Kushagra340/KushagraBot-ROS2/media/tf_tree.pdf

view_frames Result

Recorded at time: 1783702412.0483854

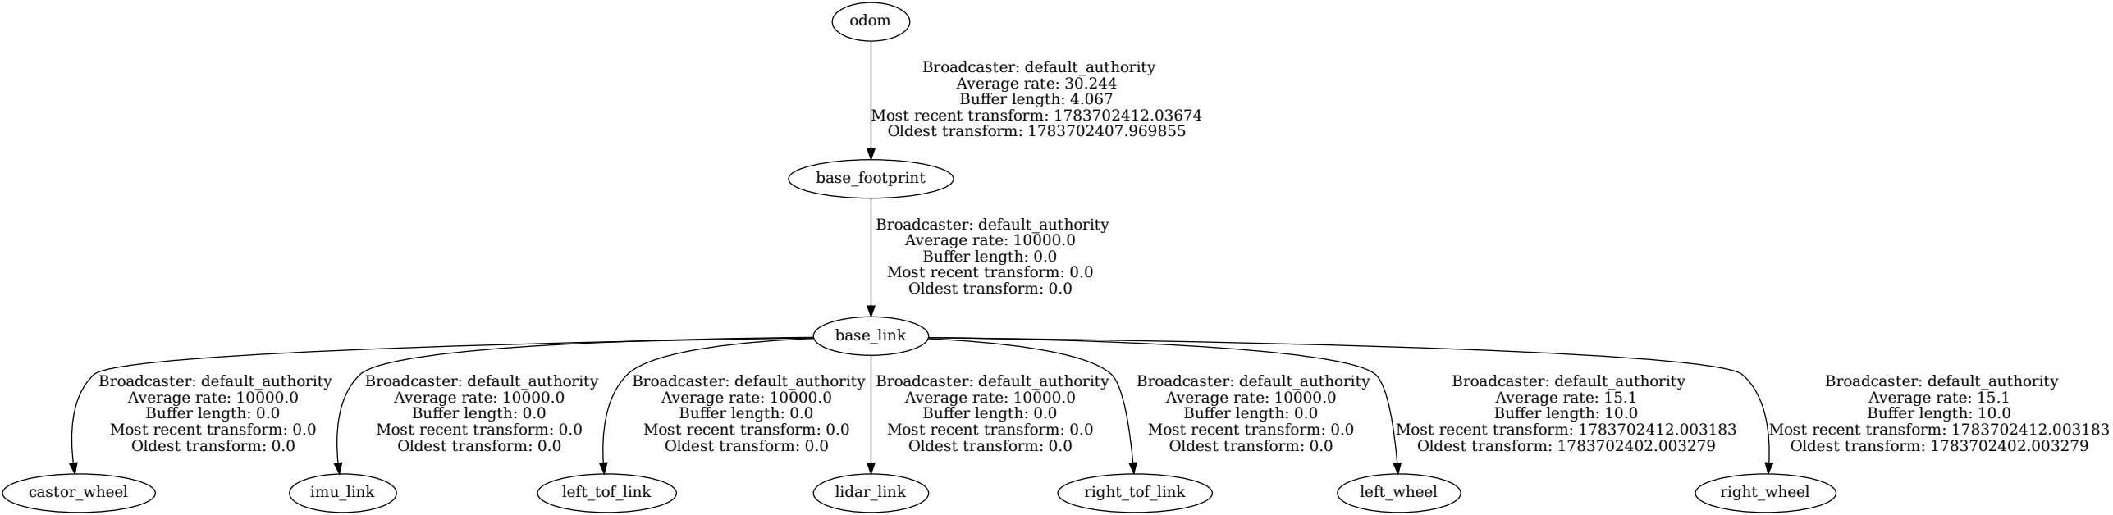
[picture p1: figure]
base_footprint; base_link; Broadcaster: default_authority Average rate: 10000.0 Buffer length: 0.0 Most recent transform: 0.0 Oldest transform: 0.0; castor_wheel; imu_link; left_tof_link; lidar_link; right_tof_link; left_wheel; Broadcaster: default_authority Average rate: 15.1 Buffer length: 10.0 Most recent transform: 1783702412.003183 Oldest transform: 1783702402.003279; right_wheel; odom; Broadcaster: default_authority Average rate: 30.244 Buffer length: 4.067 Most recent transform: 1783702412.03674 Oldest transform: 1783702407.969855
