Kushagra340/KushagraBot-ROS2/hardware/bom/Robotics_Project_BOM_Final.xlsx

Sr. No. | Website | Component Name | Link | Quantity | Est. Unit Price (₹) | Total Price (₹)
1 | robu.in | KCD1 2 Pin 10A 250V AC SPST Red Rocker Switch | https://robu.in/product/kcd1-101-spst-mini-rocker-switch-2pinon-off/ | 5 | ₹11.00 | ₹55.00 | 3112.00
2 | robu.in | Noel Soldering Iron Kit 25W 7 in 1 | https://robu.in/product/noel-soldering-iron-kit-25w-7-in-1/ | 1 | ₹490.00 | ₹490.00
3 | robu.in | High Quality Ultra Flexible 24AWG Silicone Wire Red (per m) | https://robu.in/product/high-quality-ultra-flexible-24awg-silicone-wire-red/ | 5 | ₹9.00 | ₹45.00
4 | robu.in | Aluminum Electrolytic Capacitor 100uF | https://robu.in/product/elxz350ell101mf15d-chemi-con-aluminum-electrolytic-capacitor-100uf-3/ | 5 | ₹17.00 | ₹85.00
5 | robu.in | 24AWG High Voltage Silicone Wire 3000V Black (per m) | https://robu.in/product/24awg-high-voltage-silicone-wire-3000v-black/ | 5 | ₹12.00 | ₹60.00
6 | robu.in | VL53L0X ToF Based Lidar Laser Distance Sensor | https://robu.in/product/vl53l0x-tof-based-lidar-laser-distance-sensor/ | 3 | ₹121.00 | ₹363.00
7 | robu.in | N20 3V 150RPM Micro Metal Gear Motor With Encoder | https://robu.in/product/n20-3v-150rpm-micro-metal-gear-motor-with-encoder/ | 2 | ₹526.00 | ₹1052.00
8 | robu.in | MPU-6050 Gyro Sensor & Accelerometer | https://robu.in/product/mpu-6050-gyro-sensor-2-accelerometer/ | 1 | ₹169.00 | ₹169.00
9 | robu.in | 34mm Mini Car N20 Motor Wheel Rubber Small Wheel | https://robu.in/product/34mm-mini-car-n20-motor-wheel-rubber-small-wheel/ | 4 | ₹50.00 | ₹200.00
10 | robu.in | Digital Multimeter Small Yellow Color LCD | https://robu.in/product/digital-multimeter-small-yellow-color-lcd-ac-dc-measuring-voltage-current/ | 1 | ₹171.00 | ₹171.00
11 | robu.in | 1203B PWM 6V 12V 24V 28V 3A DC Motor Speed Regulator | https://robu.in/product/1203b-pwm-6v-12v-24v-28v-3a-dc-motor-speed-regulator/ | 1 | ₹84.00 | ₹84.00
12 | robu.in | Green ESP32 Breakout Board for 38Pin ESP32 | https://robu.in/product/green-esp32-breakout-board-for-38pin-esp32-development-board/ | 1 | ₹235.00 | ₹235.00
13 | robu.in | 12V Cold White 5050 SMD LED Strip 1Meter | https://robu.in/product/12v-cold-white-5050-smd-led-strip-1meter/ | 1 | ₹103.00 | ₹103.00
14 | robokits.co.in | M3 x 20 mm CSK Bolt Stainless Steel 304 (Piece) | https://robokits.co.in/mechanical-parts/nut-bolts-standoffs/flat-head-csk-bolt/m3-x-20-mm-csk-bolt-stainless-steel-304-moq-25-pcs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 | 50 | ₹2.36 | ₹118.00 | 693.84
15 | robokits.co.in | DC-DC Boost 25V 2A MT3608 | https://robokits.co.in/power-supply/dc-dc-power-supply/dc-dc-boost-25v-2a-mt3608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 | 2 | ₹33.04 | ₹66.08
16 | robokits.co.in | M3 Nuts 304 Stainless Steel (Piece) | https://robokits.co.in/robot-parts/nut-bolts-standoffs/nuts/m3-nuts-304-stainless-steel-moq-50-pcs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 | 50 | ₹1.18 | ₹59.00
17 | robokits.co.in | M3 x 3 mm Brass Heat Threaded Round Insert Nut (Piece) | https://robokits.co.in/robot-parts/nut-bolts-standoffs/nuts/m3-x-3-mm-brass-heat-threaded-round-insert-nut-moq-25-pcs.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 | 25 | ₹4.48 | ₹112.10
18 | robokits.co.in | M3 Flat Washer 304 Stainless Steel (Piece) | https://robokits.co.in/robot-parts/nut-bolts-standoffs/washers/m3-flat-washer-304-stainless-steel-moq-50-pcs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 | 50 | ₹2.83 | ₹141.60
19 | robokits.co.in | Two Way Motor Drive Module DRV8833 | https://robokits.co.in/motor-drives-drivers/dc-motor-driver/two-way-motor-drive-module-drv8833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 | 1 | ₹94.40 | ₹94.40
20 | robokits.co.in | Turbo Fan Blower | https://robokits.co.in/3d-printer/accessories/turbo-fan-blower | 1 | ₹102.66 | ₹102.66
21 | flyrobo.in | 18650 Battery Shield for Raspberry Pi and Arduino ESP8266 | https://www.flyrobo.in/18650-battery-shield-for-raspberry-pi-andarduino-esp8266 | 1 | ₹157.00 | ₹157.00 | 1192.00
22 | flyrobo.in | Li-ion 18650 3.7V 2200mAh Battery 1C | https://www.flyrobo.in/li-ion-18650-3.7v-2200mah-battery-1c | 2 | ₹96.00 | ₹192.00
23 | flyrobo.in | Mini 3pi Car N20 Caster Robot Ball Wheel | https://www.flyrobo.in/mini-3pi-car-n20-caster-robot-ball-wheel | 1 | ₹39.00 | ₹39.00
24 | flyrobo.in | 230pcs XH 2.54 Terminal Kit Housing Pin Header JST Connector | https://www.flyrobo.in/230pcs-xh-2.54-2p-3p-4p-5pin-2.54mm-pitch-terminal-kit-housing-pin-header-jst-connector | 1 | ₹366.00 | ₹366.00
25 | flyrobo.in | ESP32 NodeMCU WiFi Bluetooth Development Module 30 Pin | https://www.flyrobo.in/esp32-node-mcu-wifi-bluetooth-development-module-30-pin | 1 | ₹438.00 | ₹438.00
 |  |  |  |  | GRAND TOTAL: | ₹4997.84
