Kushagra340/KushagraBot-ROS2/hardware/cad/chassis v2.SLDPRT

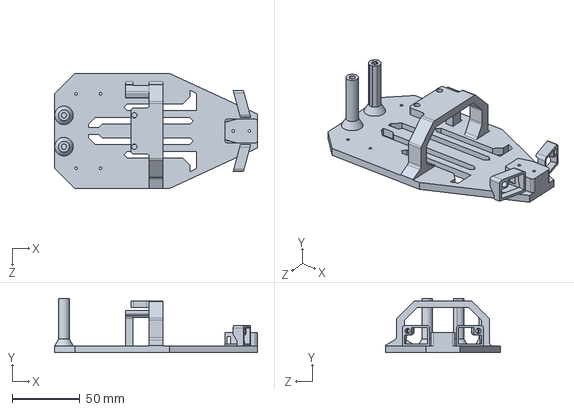
[picture p2: CAD file, 2026-10-18]
hardware/cad/chassis v2.SLDPRT
150.0 x 40.0 x 85.0 mm
