Kushagra340/KushagraBot-ROS2/hardware/cad/BASE PLATE V3.SLDPRT

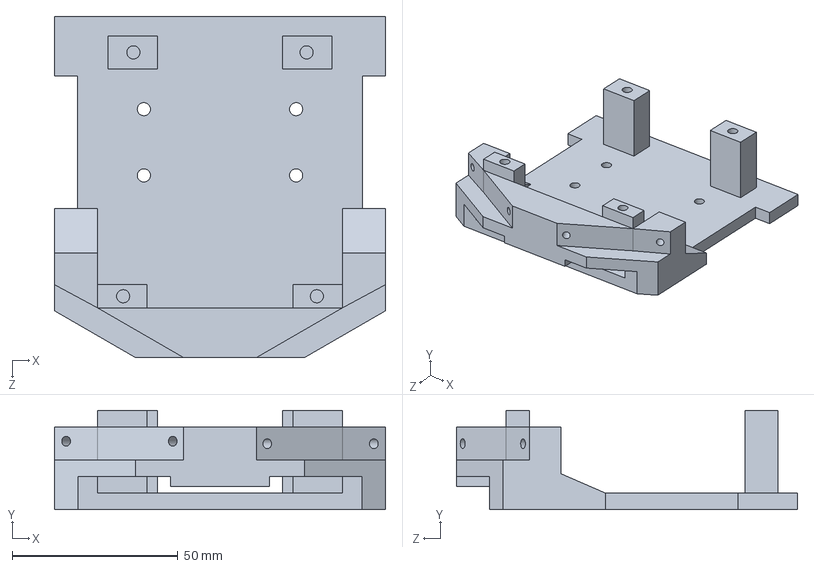
[picture p3: CAD file, 2026-10-18]
hardware/cad/BASE PLATE V3.SLDPRT
100.0 x 30.0 x 103.0 mm
