Kushagra340/KushagraBot-ROS2/hardware/cad/Bracket.SLDPRT

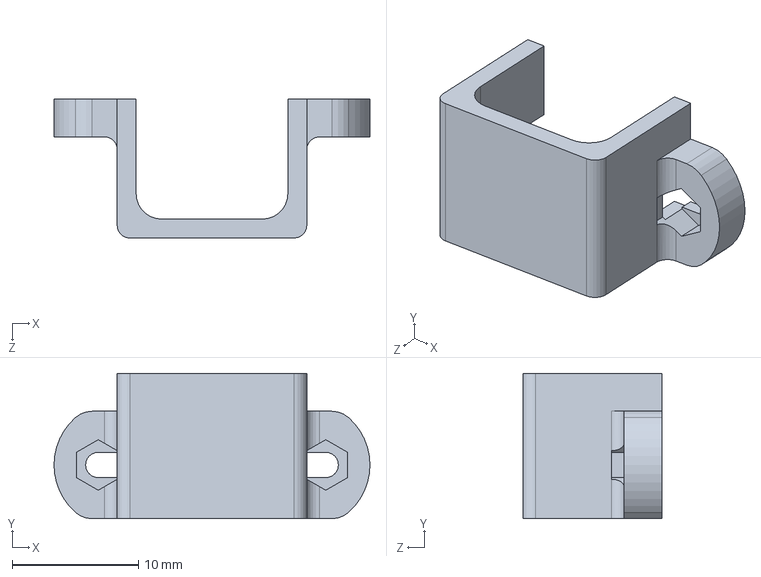
[picture p4: CAD file, 2026-10-18]
hardware/cad/Bracket.SLDPRT
25.0 x 11.5 x 11.0 mm
