Kushagra340/KushagraBot-ROS2/(list of files, cad)

Other CAD files:
hardware/cad/chassis v2.STL
