Kushagra340/KushagraBot-ROS2/docs/robot_building_mastery_guide.md

# The Path to Mastery: Building a "Good" Robot in ROS 2

Building a "good" robot means creating a system that is robust, reliable, and predictable. A robot that looks cool but fails when a single sensor disconnects is a toy; a robot that handles edge cases gracefully and moves smoothly is a professional machine. 

This document serves as a comprehensive roadmap from beginner to mastery, covering both simulation and real-world hardware using ROS 2.

---

## 1. Nav2 Controllers (Local Planners) Comparison

The "Controller" (or Local Planner) is the brain behind the robot's physical movement. It takes the global path and generates velocity commands (`cmd_vel`) to avoid dynamic obstacles and reach the goal smoothly.

Choosing the right controller drastically changes how "good" your robot feels.

| Controller | Full Name | Best For | Pros | Cons |
| :--- | :--- | :--- | :--- | :--- |
| **DWB** | Dynamic Window Approach | General purpose diff-drive | Reliable, industry standard, highly configurable with plugins. | Can get stuck in narrow spaces or local minima. Tuning can be tedious. |
| **MPPI** | Model Predictive Path Integral | High-speed, dynamic environments | Extremely smooth, looks ahead to avoid obstacles smoothly, great for Ackermann/Omni. | Very CPU/GPU intensive. Requires a good processor (e.g., Jetson). |
| **RPP** | Regulated Pure Pursuit | Simple path following, industrial robots | Very lightweight, fast, adheres strictly to the global path. | Poor dynamic obstacle avoidance. Will stop if the path is blocked rather than driving around. |
| **TEB** | Timed Elastic Band | Complex maneuvers, parking | Excellent for car-like robots (Ackermann) and tight spaces. | Can be computationally heavy and sometimes oscillates in tight corridors. |
| **Graceful**| Graceful Controller | Smooth, human-friendly movement | Prioritizes smooth curves and graceful stops over aggressive speed. | Not ideal for high-speed racing or highly dynamic environments. |

> [!TIP]
> **Recommendation:** Start with **DWB** for learning. Upgrade to **MPPI** if you have the compute power and want beautiful, smooth, predictive avoidance. Use **RPP** if you just want the robot to strictly follow a line and stop if blocked.

---

## 2. Simulation Mastery (Gazebo)

A "good" simulation should mimic reality as closely as possible. If your simulation is too perfect, your code will fail on the real robot.

### Making Simulation Realistic
1. **Accurate Physics (URDF/Xacro):**
   - **Inertia:** Never guess inertia. Calculate it based on the shape (box, cylinder) and mass of each link. Wrong inertia makes the robot jitter or flip.
   - **Friction (`mu1`, `mu2`):** Wheels should have high friction; caster wheels should have `mu1 = 0.0` and `mu2 = 0.0` so they slide perfectly without snagging.
2. **Sensor Noise:** Real sensors are noisy. Always add `<noise>` tags with Gaussian distributions to your Gazebo LIDAR and IMU plugins. If your SLAM algorithm can't handle simulated noise, it will fail in the real world.
3. **Control Rate:** Ensure your `ros2_control` or Gazebo diff-drive plugin runs at a realistic frequency (e.g., 50Hz). 

---

## 3. Real-World Hardware & Electronics

Building the physical robot requires bridging the gap between high-level AI and low-level electrical signals.

### Compute Brain (Single Board Computer - SBC)
This runs Linux, ROS 2, Nav2, and SLAM.
- **Budget/Beginner:** Raspberry Pi 4 (4GB+) or Raspberry Pi 5.
- **Advanced/AI-Focused:** Nvidia Jetson Nano (legacy), Jetson Orin Nano, or an Intel NUC (x86 architecture is often easier for ROS 2).

### Low-Level Brain (Microcontroller - MCU)
This handles real-time tasks: reading encoders, running PID loops, and generating PWM for motors.
- **ESP32:** Best overall. Fast, cheap, has WiFi/Bluetooth, and works perfectly with `micro-ROS`.
- **Teensy 4.0/4.1:** The king of raw speed. Perfect for complex kinematics or high-frequency motor control.
- **Arduino Mega/Uno:** Good for learning, but too slow and lacks memory for modern `micro-ROS` applications. Use ESP32 instead.

### Actuators (Motors)
- **DC Gear Motors with Encoders:** The standard for wheeled robots. You **MUST** have quadrature encoders (usually Hall effect) attached to the motor shafts to measure wheel rotations (Odometry).
- **BLDC (Brushless DC) Motors:** Used in hoverboards or Boston Dynamics-style robots. They require complex ESCs (ODrive) but offer insane torque and smoothness.
- **Stepper Motors:** Good for precise robotic arms, but terrible for wheeled navigation (they lack freewheeling and consume power when stationary).

### Motor Drivers
Do NOT use the ancient **L298N** (red board). It drops 2V of power as heat and is terribly inefficient.
- **For small motors:** TB6612FNG or DRV8833.
- **For medium motors (up to 10A):** Cytron MD10C or MDD10A (Highly recommended, very reliable).
- **For large motors (up to 43A):** BTS7960.

### Power System (The most common point of failure)
- **Battery:** Use a 3S (11.1V) or 4S (14.8V) LiPo battery. Ensure you have a low-voltage alarm so you don't destroy the battery.
- **Power Distribution:**
  - **Motors** should be powered directly from the battery (through a fuse and switch).
  - **Raspberry Pi / Jetson** MUST be powered via a high-quality **Buck Converter** (Step-down module). If your Pi needs 5V/3A, get a buck converter rated for 5V/5A to be safe. Brownouts will cause the Pi to reboot mid-drive.
  - **Sensors/MCU** can usually be powered from the Pi's USB, but high-draw sensors (like some LIDARs) need their own buck converter.

---

## 4. Real-World Sensors

To navigate, the robot must answer two questions: *Where am I?* (Odometry) and *What's around me?* (Perception).

### Odometry (Crucial for a "Good" Robot)
If odometry is bad, Nav2 will fail completely.
1. **Wheel Encoders:** Provide base odometry. The MCU reads encoder ticks and calculates distance traveled. 
2. **IMU (Inertial Measurement Unit):** Fixes rotation errors. Wheels slip when turning, so encoders lie about rotation. An IMU (like the BNO080/BNO085 or MPU6050) provides accurate heading.
   - *Pro Tip:* Use `robot_localization` (an EKF node in ROS 2) to fuse wheel odometry and IMU data together into a perfect `odom -> base_link` TF.

### Perception
1. **2D LIDAR:** RPLidar A1/A2 or YDLidar X4. These provide a 360-degree slice of the world. Essential for SLAM (mapping) and costmaps.
2. **Depth Cameras (3D):** Intel RealSense (D435i) or OAK-D. These see in 3D and can detect obstacles that are lower or higher than the 2D LIDAR plane (like tables or small shoes).

---

## 5. Software Architecture for the Real Robot

Bridging the SBC (Raspberry Pi) and the MCU (ESP32):

> [!IMPORTANT]
> **Use `micro-ROS` or `ros2_control`**
> The best modern approach is to flash **micro-ROS** onto your ESP32. This makes the ESP32 a native ROS 2 node! The ESP32 subscribes directly to `/cmd_vel` over USB/Serial and publishes `/odom`. 
> Alternatively, write a hardware interface for `ros2_control` that communicates with your ESP32 via a custom serial protocol.

### The Standard ROS 2 Hardware Stack:
1. **SBC (Raspberry Pi)** runs:
   - `nav2` stack
   - `slam_toolbox` (or `map_server` + `amcl`)
   - `robot_state_publisher` (URDF)
   - `rplidar_ros` (LIDAR driver)
   - `micro_ros_agent` (bridges the serial connection to the MCU)
2. **MCU (ESP32)** runs:
   - Hardware interrupts to count encoder ticks.
   - A PID loop running at 100Hz to maintain the requested wheel speeds.
   - Subscribes to `geometry_msgs/Twist` (`cmd_vel`).
   - Publishes `nav_msgs/Odometry` (`odom`).

---

## 6. Characteristics of a "Mastered" Robot System

1. **Safety First:** A physical Emergency Stop (E-Stop) button that cuts power to the motor driver (but leaves the computer on).
2. **Proper Grounding:** All electronic components (Pi, MCU, Motor Driver, Sensors) MUST share a common ground line. Failure to do this causes noisy, erratic behavior.
3. **TF Tree Integrity:** A clean, unbroken TF tree: `map` -> `odom` -> `base_link` -> `laser_link`.
4. **Parameter Modularity:** Never hardcode parameters. Everything (PID gains, wheelbase length, max speeds) should be loaded from a YAML file.
5. **Diagnostics:** The robot should publish battery voltage and motor temperatures to standard ROS 2 diagnostic topics.

---

### Conclusion

Mastery in ROS 2 robotics comes from isolating the software from the hardware. If your URDF is accurate, your TF tree is clean, and your ESP32 accurately translates `/cmd_vel` into physical wheel speeds while returning accurate `/odom`, then your simulation code will run on the real robot with almost zero changes.
