Kushagra340/KushagraBot-ROS2/docs/controller_tuning_guide.md

# 🎮 The Ultimate Guide to Robot Controllers!

If you want your robot to build a perfect map (SLAM) without getting dizzy, it needs to drive **smoothly**. If your robot jerks around like a crazy bumper car, the Lidar (the robot's eyes) gets blurry, and the map turns into a messy scribble! 

Here is how you can tweak the "brains" (controllers) in your `nav2_params.yaml` file to make your robot drive perfectly, explained so simply that anyone can understand!

---

## 🥕 1. Regulated Pure Pursuit (RPP)
**How it works:** Imagine you are dangling a carrot on a stick in front of a hungry bunny. The bunny will always run towards the carrot!
**Why it's good:** It's super smooth and great for normal driving.

### What to Tweak:
- `lookahead_dist`: **(How long the stick is)**
  - *Make it smaller (e.g., 0.3):* The carrot is very close. The robot will wiggle a lot to stay exactly on the path. (Might make SLAM dizzy!)
  - *Make it bigger (e.g., 1.0):* The carrot is far away. The robot will take smooth, wide turns and cut corners. (Very smooth for SLAM!)
- `desired_linear_vel`: **(How hungry the bunny is)**
  - This is your top speed. Keep it around `0.5` so the robot doesn't go too fast and crash!
- `use_regulated_linear_velocity_scaling`: **(The caution mode)**
  - Keep this `true`! It tells the robot to slow down before it takes a sharp turn, just like you would on a bicycle.

> [!TIP]
> **For the Best SLAM:** Increase the `lookahead_dist` slightly if the robot is wiggling too much on straight lines!

---

## 🏎️ 2. Dynamic Window Approach (DWB)
**How it works:** Imagine you are playing a video game where you look at all possible moves (steer left, steer right, go straight) and score them based on how safe they are. The robot picks the move with the highest score!
**Why it's good:** It's very safe and avoids obstacles like a pro.

### What to Tweak:
- `max_vel_x` and `max_vel_theta`: **(The Speed Limit)**
  - Maximum driving and turning speeds. If you set `max_vel_theta` too high, the robot spins too fast and SLAM loses track of where it is!
- `sim_time`: **(Looking into the future)**
  - *Make it bigger (e.g., 2.5):* The robot looks further into the future to score its moves. Good for wide open spaces, but it thinks too much in tight spaces.
  - *Make it smaller (e.g., 1.5):* Quick reactions for tight mazes!
- `critics`: **(The Judges)**
  - These are the rules that give points to moves. If you want the robot to stick closer to the path, you can tweak the weights of the `PathAlign` and `GoalAlign` critics in the config file.

> [!WARNING]
> If DWB gets stuck, it's usually because the judges are being too strict. Try lowering the maximum speeds so it has more time to think.

---

## ✈️ 3. Model Predictive Path Integral (MPPI)
**How it works:** Imagine throwing 2,000 paper airplanes all at once. Whichever airplane lands closest to the goal without hitting a wall is the path the robot chooses! 
**Why it's good:** It is insanely smart at threading the needle through forests of obstacles.

### What to Tweak:
- `batch_size`: **(How many airplanes to throw)**
  - `2000` is great. If you make it `5000`, the robot gets smarter but your computer's CPU might catch on fire!
- `time_steps`: **(How far the airplanes fly)**
  - *Make it bigger (e.g., 80):* Looks further ahead to solve complex mazes.
- `vx_std` & `wz_std`: **(How wildly you throw them)**
  - This is the "randomness". If you increase `wz_std`, the robot considers crazy spin moves. Keep it low enough (around `0.4`) so the robot doesn't try silly things.

> [!IMPORTANT]
> MPPI needs a powerful computer. If your simulation starts lagging, turn down the `batch_size`!

---

## 💃 4. Graceful Controller
**How it works:** Think of a professional ice skater sliding smoothly into the finish line. It uses fancy math curves to make sure every turn looks beautiful and effortless.
**Why it's good:** Creates the prettiest, most cinematic robot movements. 

### What to Tweak:
- `k_phi` & `k_delta`: **(The steering tightness)**
  - Increase these if the robot is drifting too far wide on turns. Decrease them if the robot is correcting itself too aggressively.
- `beta`: **(The smoothness factor)**
  - Think of this as the "gracefulness" dial. Tweak it slightly (between `0.2` and `0.6`) to see how it changes the arc of the turns.

---

## 🧲 5. Vector Pursuit (VPP)
**How it works:** Similar to RPP (the carrot), but instead of just looking at a point on the path, it looks at the *direction* (vector) of the path. It's like being pulled along a magnetic wire!
**Why it's good:** Better at sticking strictly to the path without cutting corners as much as RPP.

### What to Tweak:
- `lookahead_dist`: **(How far down the wire you look)**
  - Just like RPP, a bigger lookahead means smoother driving but slight corner cutting. A smaller lookahead means strict path following but potential wiggles.

---

### 🌟 Summary: How to help SLAM!
If your map is coming out broken or looped, your SLAM algorithm is getting dizzy! To fix a dizzy robot:
1. **Lower your turning speed** (`max_vel_theta` or `rotate_to_heading_angular_vel`). Lidar hates fast spinning!
2. **Increase lookahead distances** in RPP/VPP so the robot doesn't aggressively wiggle left and right to stay perfectly on a line.
3. **Use smooth decelerations** so the robot doesn't slam on the brakes.
