Kushagra340/KushagraBot-ROS2/ros2_ws/src/kushagrabot_description/config/controllers.yaml

controller_manager:
  ros__parameters:
    update_rate: 30  # Hz

    joint_state_broadcaster:
      type: joint_state_broadcaster/JointStateBroadcaster

    diff_drive_controller:
      type: diff_drive_controller/DiffDriveController

diff_drive_controller:
  ros__parameters:
    left_wheel_names: ["left_wheel_joint"]
    right_wheel_names: ["right_wheel_joint"]

    wheel_separation: 0.119
    wheel_radius: 0.017

    wheel_separation_multiplier: 1.0
    left_wheel_radius_multiplier: 1.0
    right_wheel_radius_multiplier: 1.0

    publish_rate: 50.0
    odom_frame_id: odom
    base_frame_id: base_footprint
    pose_covariance_diagonal: [0.001, 0.001, 0.0, 0.0, 0.0, 0.01]
    twist_covariance_diagonal: [0.001, 0.0, 0.0, 0.0, 0.0, 0.01]

    enable_odom_tf: false

    cmd_vel_timeout: 0.5
    use_stamped_vel: false

    # Velocity and acceleration limits
    linear.x.has_velocity_limits: true
    linear.x.has_acceleration_limits: true
    linear.x.has_jerk_limits: false
    linear.x.max_velocity: 0.5
    linear.x.min_velocity: -0.5
    linear.x.max_acceleration: 1.0
    linear.x.min_acceleration: -1.0

    angular.z.has_velocity_limits: true
    angular.z.has_acceleration_limits: true
    angular.z.has_jerk_limits: false
    angular.z.max_velocity: 2.0
    angular.z.min_velocity: -2.0
    angular.z.max_acceleration: 3.0
    angular.z.min_acceleration: -3.0
