Kushagra340/KushagraBot-ROS2/(notices)

Notices in the files:
README.md:
License: MIT
